giorgia22/Thermometer/schema elettrico imm.png

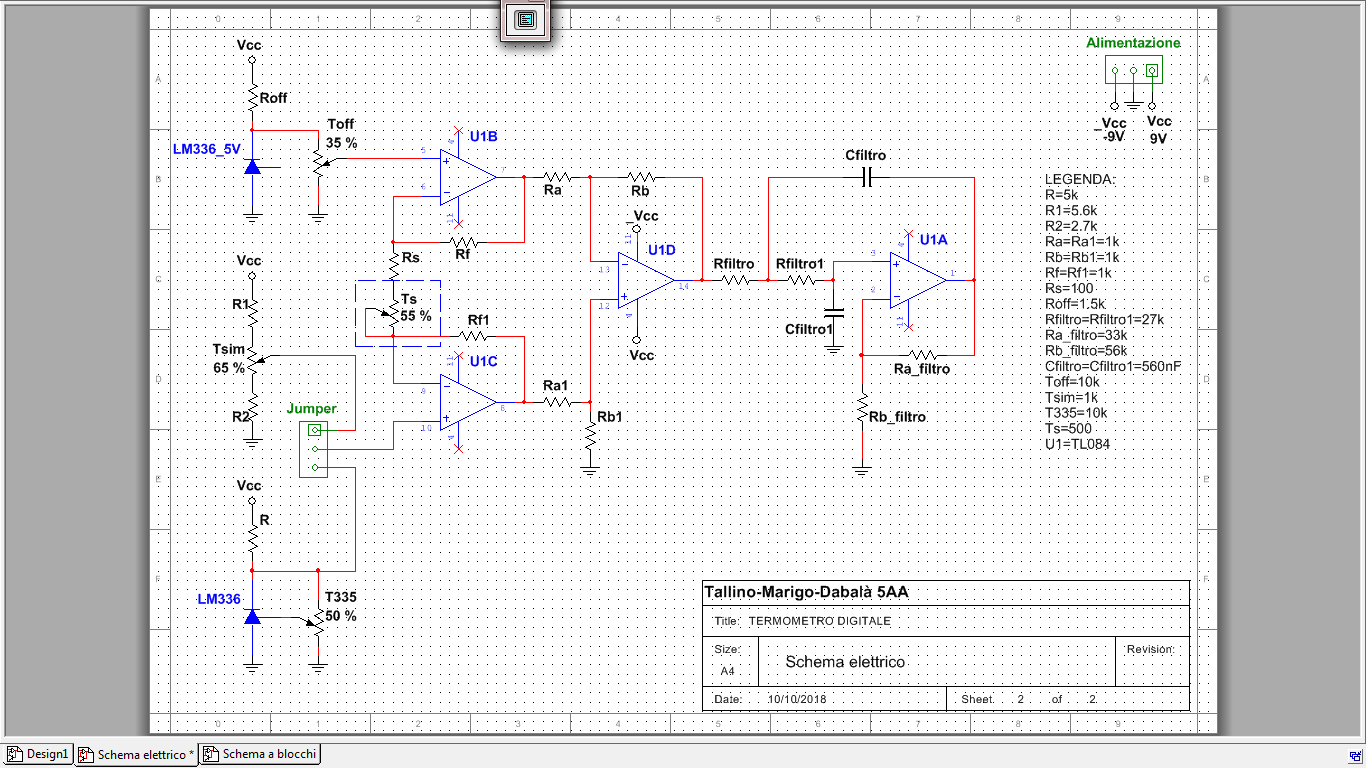
schema elettrico imm.png
