giorgia22/Thermometer/(list of files, drawings)

Other design files:
Schema elettrico.ms14
